andrea-tarabay/alive-active-leash/data/acceleration_plot.png

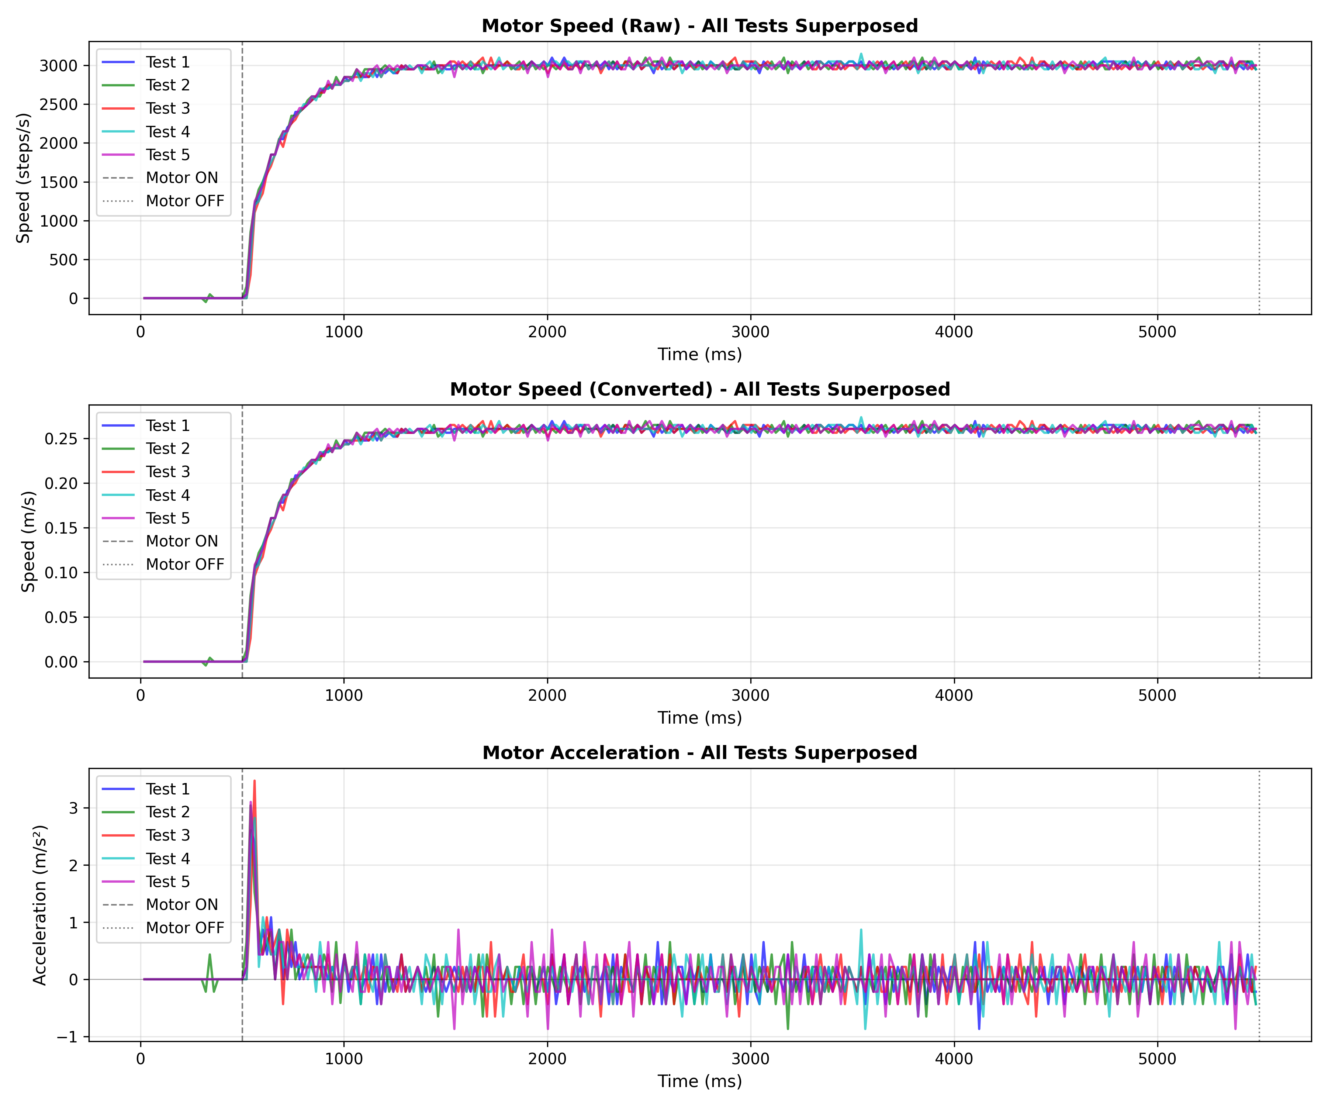
data/acceleration_plot.png
