andrea-tarabay/alive-active-leash/data/regression_plot_full.png

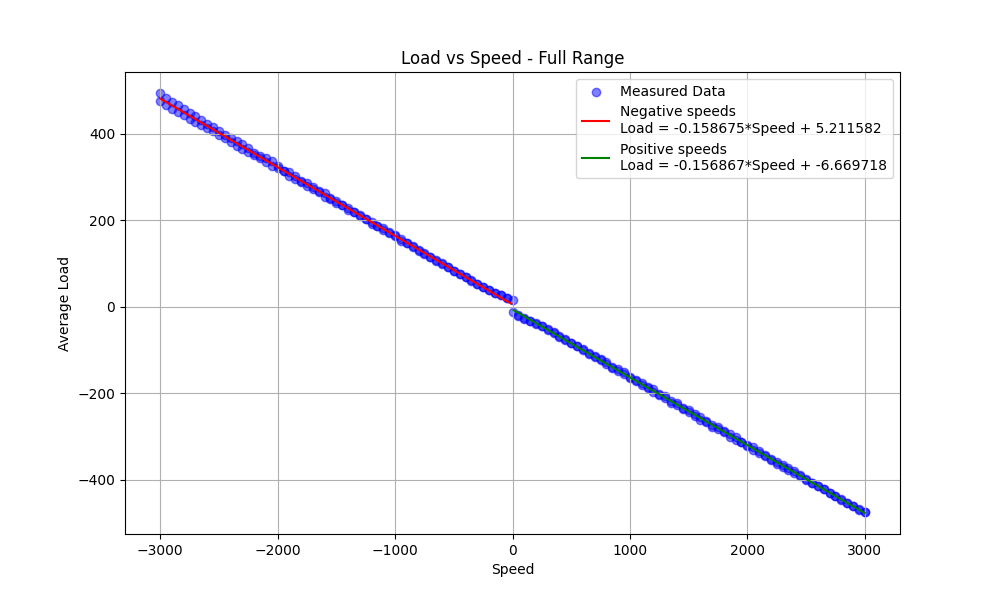
data/regression_plot_full.png
