andrea-tarabay/alive-active-leash/data/regression_plot_zoomed.png

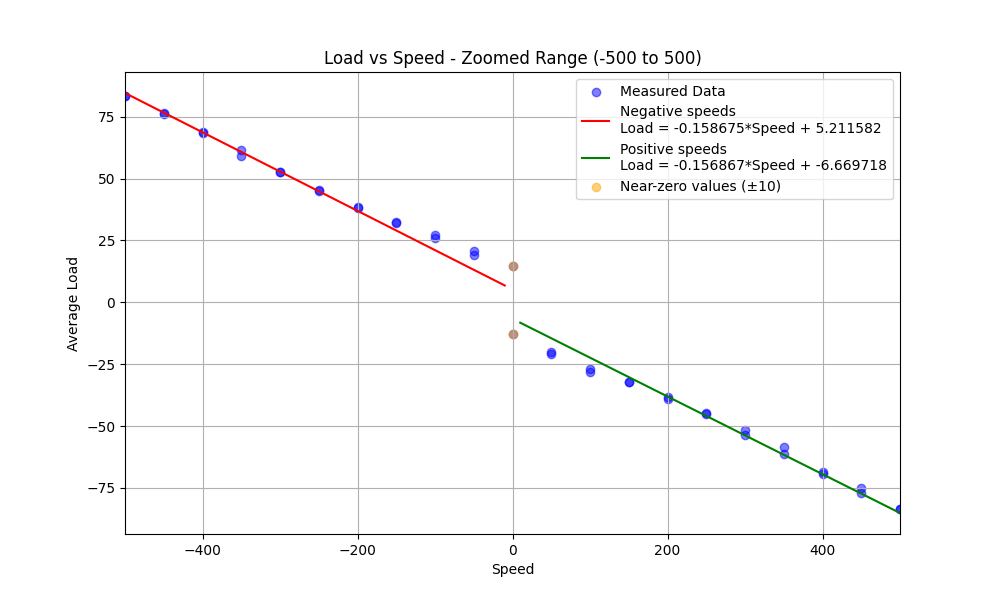
data/regression_plot_zoomed.png
