andrea-tarabay/alive-active-leash/acceleration_test/acceleration_stats.csv

AccelerationParam | MeanMaxAcceleration | StdMaxAcceleration | NumTests
0 | 13264.790764790765 | 4427.35794683208 | 6
10 | 10099.206349206348 | 3370.2719931984816 | 6
25 | 10124.458874458876 | 1557.6365515480945 | 6
50 | 10010.82251082251 | 3015.9938389324634 | 6
75 | 10306.637806637806 | 2171.000946169014 | 6
100 | 10782.82828282828 | 2173.373474907396 | 6
150 | 10892.857142857141 | 2304.0661254630745 | 6
200 | 10515.873015873016 | 2485.5804572565125 | 6
255 | 12559.52380952381 | 4357.180804761458 | 6
