andrea-tarabay/alive-active-leash/acceleration_test/acceleration_test_v2_data.csv

TestNum | TargetSpeed | Acceleration | Time_ms | Speed | Phase
0 | 0 | 0 | 0 | 50 | STOPPING
0 | 0 | 0 | 21 | 100 | STOPPING
0 | 0 | 0 | 43 | 100 | STOPPING
0 | 0 | 0 | 64 | 100 | STOPPING
0 | 0 | 0 | 86 | 50 | STOPPING
0 | 0 | 0 | 106 | 0 | STOPPING
0 | 0 | 0 | 128 | 100 | STOPPING
0 | 0 | 0 | 148 | 0 | STOPPING
0 | 0 | 0 | 169 | 100 | STOPPING
0 | 0 | 0 | 190 | 0 | STOPPING
0 | 0 | 0 | 211 | 0 | STOPPING
0 | 0 | 0 | 231 | 50 | STOPPING
0 | 0 | 0 | 252 | 0 | STOPPING
0 | 0 | 0 | 273 | 0 | STOPPING
0 | 0 | 0 | 294 | 0 | STOPPING
0 | 0 | 0 | 314 | 0 | STOPPING
0 | 0 | 0 | 335 | 50 | STOPPING
0 | 0 | 0 | 356 | 0 | STOPPING
0 | 0 | 0 | 377 | 50 | STOPPING
0 | 0 | 0 | 397 | 0 | STOPPING
0 | 0 | 0 | 419 | 50 | STOPPING
0 | 0 | 0 | 439 | 50 | STOPPING
0 | 0 | 0 | 459 | 0 | STOPPING
0 | 0 | 0 | 480 | 0 | STOPPING
0 | 0 | 0 | 501 | 0 | STOPPING
0 | 0 | 0 | 522 | 0 | STOPPING
0 | 0 | 0 | 542 | 0 | STOPPING
0 | 0 | 0 | 563 | 0 | STOPPING
0 | 0 | 0 | 584 | 0 | STOPPING
0 | 0 | 0 | 605 | 0 | STOPPING
0 | 0 | 0 | 625 | 0 | STOPPING
0 | 0 | 0 | 646 | 0 | STOPPING
0 | 0 | 0 | 667 | 0 | STOPPING
0 | 0 | 0 | 688 | 0 | STOPPING
0 | 0 | 0 | 708 | 0 | STOPPING
0 | 0 | 0 | 729 | 0 | STOPPING
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
