andrea-tarabay/alive-active-leash/acceleration_test/acceleration_tests_all_superposed.png

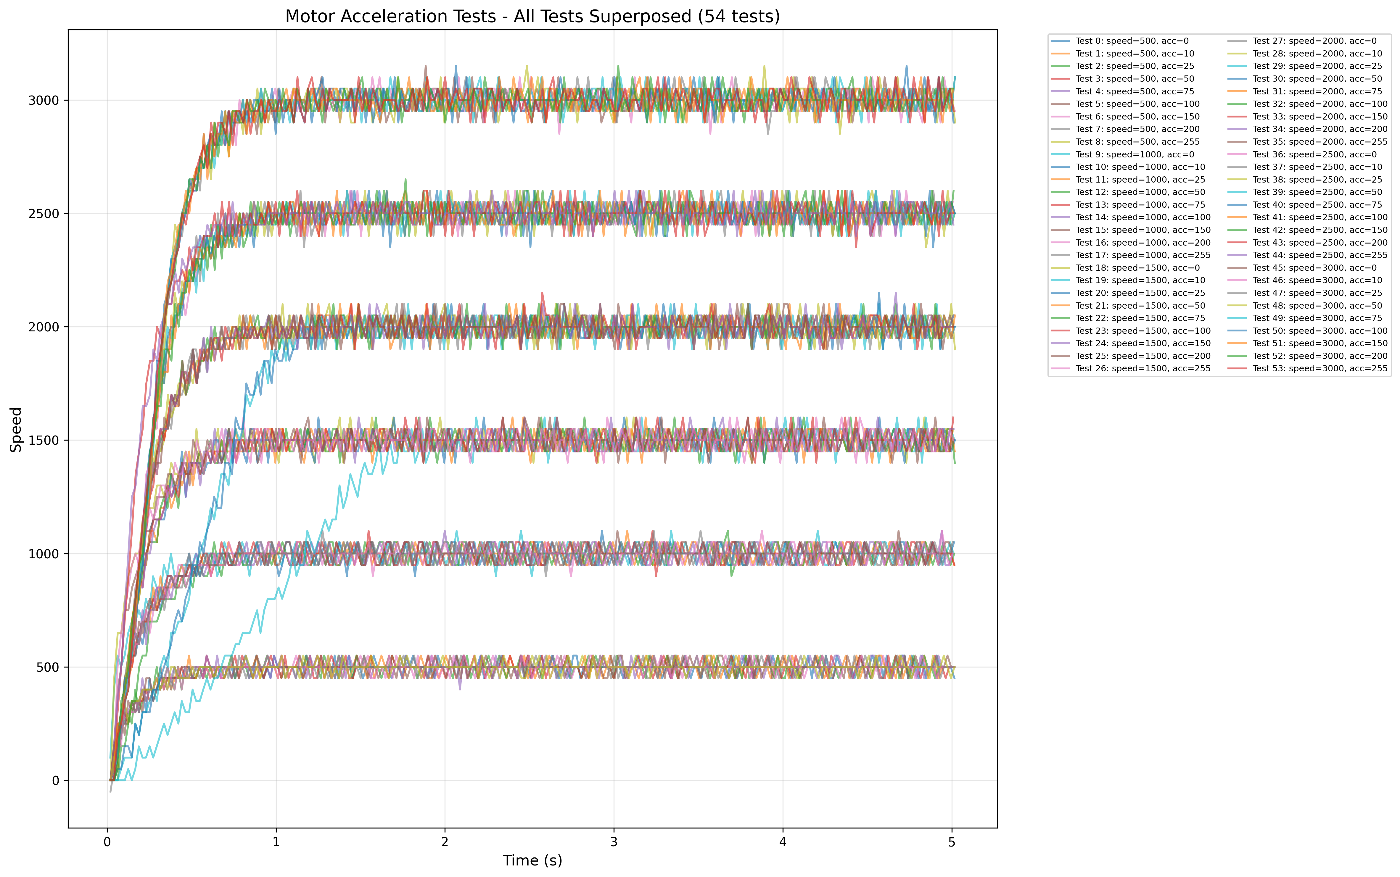
acceleration_test/acceleration_tests_all_superposed.png
