andrea-tarabay/alive-active-leash/load_conversion/motor.cpp

#include "Motor.h"
#include <Arduino.h>

Motor::Motor(uint8_t id, SMS_STS* bus, float staticC, float viscousC, int speedLimit)
: motorID(id), servoBus(bus),
  staticCoeff(staticC), viscousCoeff(viscousC), speedThreshold(speedLimit)
{
    // default residual filter: alpha between 0 (max smoothing) and 1 (no smoothing)
    residualFilterAlpha = 0.08f;  // Balanced filtering
    residualFiltered = 0.0f;
}

//only for the spool motor, hardcoded from experimental data
float Motor::computeTorque(int speed)
{
    // Lookup table generated from experimental data
    // Speed range: -3000 to 3000 in steps of 50
    // Array index = (speed + 3000) / 50
    static const float loadTable[] = {
        484.50f,   // -3000
        474.55f,   // -2950
        466.00f,   // -2900
        458.60f,   // -2850
        449.60f,   // -2800
        441.90f,   // -2750
        434.30f,   // -2700
        425.65f,   // -2650
        418.45f,   // -2600
        410.90f,   // -2550
        402.00f,   // -2500
        393.80f,   // -2450
        385.20f,   // -2400
        378.10f,   // -2350
        370.70f,   // -2300
        361.75f,   // -2250
        353.90f,   // -2200
        346.65f,   // -2150
        338.45f,   // -2100
        331.10f,   // -2050
        322.80f,   // -2000
        313.90f,   // -1950
        306.70f,   // -1900
        298.55f,   // -1850
        289.85f,   // -1800
        282.40f,   // -1750
        275.00f,   // -1700
        266.60f,   // -1650
        258.30f,   // -1600
        250.35f,   // -1550
        242.70f,   // -1500
        234.80f,   // -1450
        226.90f,   // -1400
        219.00f,   // -1350
        210.65f,   // -1300
        202.80f,   // -1250
        194.05f,   // -1200
        186.00f,   // -1150
        178.65f,   // -1100
        170.80f,   // -1050
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
    };

    // Clamp speed to valid range
    if (speed < -3000) speed = -3000;
    if (speed > 3000) speed = 3000;

    // Calculate array index: index = (speed + 3000) / 50
    int index = (speed + 3000) / 50;
    
    // Direct array lookup - O(1) constant time
    return loadTable[index];
}

long Motor::getPos()
{
    // read present pos from servo
    int raw = servoBus->ReadPos(motorID);

    int diff = raw - lastRaw;

    // wrap-around
    if(diff >  2000) accumulated -= 4096; // ex: 10 → 4090
    if(diff < -2000) accumulated += 4096; // ex: 4090 → 10

    lastRaw = raw;

    // absolue position = raw + accumulated
    return raw + accumulated- initialRaw;
}

int Motor::getSpeed()
{
    return servoBus->ReadSpeed(motorID);
}

int Motor::getTorque()
{
    return servoBus->ReadLoad(motorID);
}

TorqueData Motor::getResidualTorque(){
    TorqueData result;
    
    // Use FeedBack to read all values at once from the servo bus
    if (servoBus->FeedBack(motorID) != -1) {
        int speed = servoBus->ReadSpeed(motorID);
        int actualLoad = servoBus->ReadLoad(motorID);
        
        result.actualTorque = actualLoad;
        float predicted;
        if(actualLoad == 0){
            predicted = 0.0f;
        }else{
            predicted = computeTorque(speed);
        }

        // torque résiduel = charge réelle - charge prédite
        result.modeledTorque = predicted;
        float rawResidual = static_cast<float>(actualLoad) - predicted;
        // exponential moving average filter
        residualFiltered = residualFiltered * (1.0f - residualFilterAlpha) + rawResidual * residualFilterAlpha;
        result.residualTorque = residualFiltered;
    } else {
        // If FeedBack fails, return zeros
        result.actualTorque = 0;
        result.modeledTorque = 0.0f;
        result.residualTorque = 0.0f;
    }
    
    return result;
}

void Motor::setResidualFilterAlpha(float alpha)
{
    if (alpha < 0.0f) alpha = 0.0f;
    if (alpha > 1.0f) alpha = 1.0f;
    residualFilterAlpha = alpha;
}

void Motor::setMode(MotorMode mode)
{   
    servoBus->unLockEprom(motorID);
    if(mode == MODE_SPEED){
        // wheel mode = 1
        servoBus->writeByte(motorID, SMS_STS_MODE, 1);
    }else{
        // joint mode = 0
        servoBus->writeByte(motorID, SMS_STS_MODE, 0);
    }
    servoBus->LockEprom(motorID);
}

//it's not suposed to be in the eeprom -> to check
void Motor::enableTorque(bool torque)
{
    servoBus->EnableTorque(motorID, torque);
}

void Motor::setSpeed(int speed)
{
    servoBus->WriteSpe(motorID, speed, 0);
}

void Motor::resetInitialRaw(){
    int raw = servoBus->ReadPos(motorID);
    initialRaw = raw;
    lastRaw = raw;
    accumulated = 0;
}
